theengineeraccelerator/Arduino-Electronic-Load/1 Product Definition/Archive/ArduinoElectronicLoad_Feature_Diagram_new.pdf

# Key

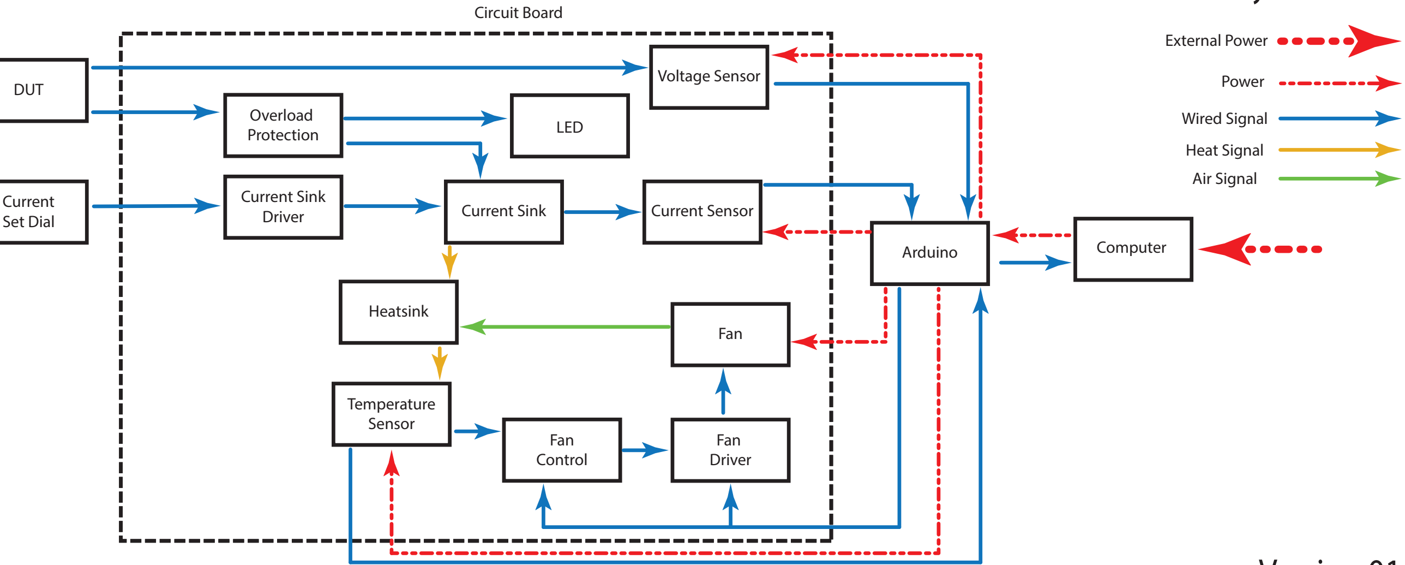
[picture p1: figure]
Power; Wired Signal; External Power; Voltage Sensor; Arduino; Current Sensor; Circuit Board; Current Sink Driver; Current; Set Dial; Current Sink; Computer; Overload Protection; Temperature Sensor; Fan Control; LED; DUT; Heatsink; Fan Driver; Heat Signal; Fan; Air Signal

# Version 01

# Arduino Electronic Load Feature Block Diagram
