theengineeraccelerator/Arduino-Electronic-Load/3 Realization/Working_Import_BOM_Ver05.xlsx

Sheet: BOM
Author
Date
Project
Version
Part | Value | Manufacturing | Manufacturing_num | Package | Vendor | Vendor_Part_num
3.5MM_JACK_IN | 35RASMT4BHNTRX | Switchcraft | 35RASMT4BHNTRX | 5 Pad Audio Jack | Mouser | 502-35RASMT4BHNTRX
3.5MM_JACK_OUT | 35RASMT4BHNTRX | Switchcraft | 36RASMT4BHNTRX | 6 Pad Audio Jack | Mouser | 503-35RASMT4BHNTRX
10KPOT | PRS11S-N20F-103B1
BATTERY
C1 | .05uF
C2 | 250uF
C5 | 10uF
OP_AMP
R1 | 10
R2 | 1.2K

Sheet: BOM Check
Part | Value | MANUFACTURING | MANUFACTURING_NUM | PACKAGE | VENDOR | VENDOR_PART_NUM
3.5MM_JACK_IN | 35RASMT4BHNTRX | Switchcraft | 35RASMT4BHNTRX | 5 Pad Audio Jack | Mouser | 502-35RASMT4BHNTRX
3.5MM_JACK_OUT | 35RASMT4BHNTRX | Switchcraft | 36RASMT4BHNTRX | 6 Pad Audio Jack | Mouser | 503-35RASMT4BHNTRX
10KPOT | PRS11S-N20F-103B1
BATTERY
C1 | .05uF
C2 | 250uF
C5 | 10uF
OP_AMP
R1 | 10
R2 | 1.2K

Sheet: Back Annotation Script
Manufacturer | MFG_Part_Number | Package | Vendor | Vendor_Part_num
Attribute 3.5MM_JACK_IN Manufacturing 'Switchcraft'; | Attribute 3.5MM_JACK_IN Manufacturing_num '35RASMT4BHNTRX'; | Attribute 3.5MM_JACK_IN Package '5 Pad Audio Jack'; | Attribute 3.5MM_JACK_IN Vendor 'Mouser'; | Attribute 3.5MM_JACK_IN Vendor_Part_num '502-35RASMT4BHNTRX';
Attribute 3.5MM_JACK_OUT Switchcraft 'Switchcraft'; | Attribute 3.5MM_JACK_OUT 35RASMT4BHNTRX '36RASMT4BHNTRX'; | Attribute 3.5MM_JACK_OUT 5 Pad Audio Jack '6 Pad Audio Jack'; | Attribute 3.5MM_JACK_OUT Mouser 'Mouser'; | Attribute 3.5MM_JACK_OUT 502-35RASMT4BHNTRX '503-35RASMT4BHNTRX';
Attribute 10KPOT Switchcraft ''; | Attribute 10KPOT 36RASMT4BHNTRX ''; | Attribute 10KPOT 6 Pad Audio Jack ''; | Attribute 10KPOT Mouser ''; | Attribute 10KPOT 503-35RASMT4BHNTRX '';
Attribute BATTERY ''; | Attribute BATTERY ''; | Attribute BATTERY ''; | Attribute BATTERY ''; | Attribute BATTERY '';
Attribute C1 ''; | Attribute C1 ''; | Attribute C1 ''; | Attribute C1 ''; | Attribute C1 '';
Attribute C2 ''; | Attribute C2 ''; | Attribute C2 ''; | Attribute C2 ''; | Attribute C2 '';
Attribute C5 ''; | Attribute C5 ''; | Attribute C5 ''; | Attribute C5 ''; | Attribute C5 '';
Attribute OP_AMP ''; | Attribute OP_AMP ''; | Attribute OP_AMP ''; | Attribute OP_AMP ''; | Attribute OP_AMP '';
Attribute R1 ''; | Attribute R1 ''; | Attribute R1 ''; | Attribute R1 ''; | Attribute R1 '';
Attribute R2 ''; | Attribute R2 ''; | Attribute R2 ''; | Attribute R2 ''; | Attribute R2 '';
Attribute ''; | Attribute ''; | Attribute ''; | Attribute ''; | Attribute '';
Attribute ''; | Attribute ''; | Attribute ''; | Attribute ''; | Attribute '';
Attribute ''; | Attribute ''; | Attribute ''; | Attribute ''; | Attribute '';
Attribute ''; | Attribute ''; | Attribute ''; | Attribute ''; | Attribute '';
Attribute ''; | Attribute ''; | Attribute ''; | Attribute ''; | Attribute '';
Attribute ''; | Attribute ''; | Attribute ''; | Attribute ''; | Attribute '';
Attribute ''; | Attribute ''; | Attribute ''; | Attribute ''; | Attribute '';
Attribute ''; | Attribute ''; | Attribute ''; | Attribute ''; | Attribute '';
Attribute ''; | Attribute ''; | Attribute ''; | Attribute ''; | Attribute '';
Attribute ''; | Attribute ''; | Attribute ''; | Attribute ''; | Attribute '';
Attribute ''; | Attribute ''; | Attribute ''; | Attribute ''; | Attribute '';
Attribute ''; | Attribute ''; | Attribute ''; | Attribute ''; | Attribute '';
Attribute ''; | Attribute ''; | Attribute ''; | Attribute ''; | Attribute '';
Attribute ''; | Attribute ''; | Attribute ''; | Attribute ''; | Attribute '';
Attribute ''; | Attribute ''; | Attribute ''; | Attribute ''; | Attribute '';
Attribute ''; | Attribute ''; | Attribute ''; | Attribute ''; | Attribute '';
Attribute ''; | Attribute ''; | Attribute ''; | Attribute ''; | Attribute '';
Attribute ''; | Attribute ''; | Attribute ''; | Attribute ''; | Attribute '';
