theengineeraccelerator/Arduino-Electronic-Load/1 Product Definition/ArduinoElectronicLoad_Feature_Diagram_ver3- MK Comments.pdf

# Key

# Arduino Electronic Load Feature Block Diagram

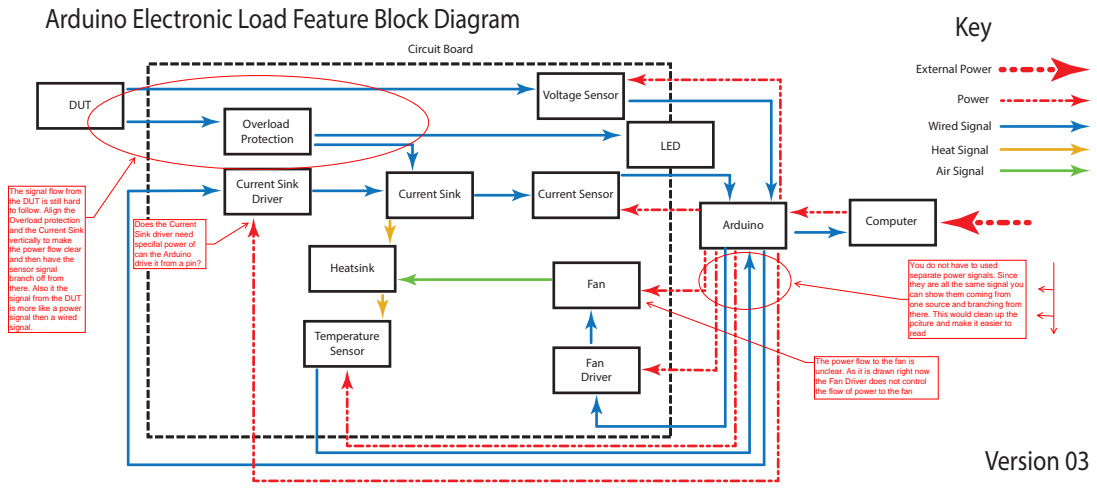
[picture p2: page 1]
Power; Wired Signal; External Power; Version 03; Voltage Sensor; Arduino; Current Sensor; Circuit Board; Current Sink Driver; Current Sink; Computer; Overload Protection; Temperature Sensor; LED; DUT; Heatsink; Fan Driver; Heat Signal; Fan; Air Signal
