theengineeraccelerator/Arduino-Electronic-Load/2 Architecture/Arduino Electronic Load Hardware Block Diagram Ver2 - MK Comments.pdf

# Arduino Electronic Load Hardware Block Diagram V02

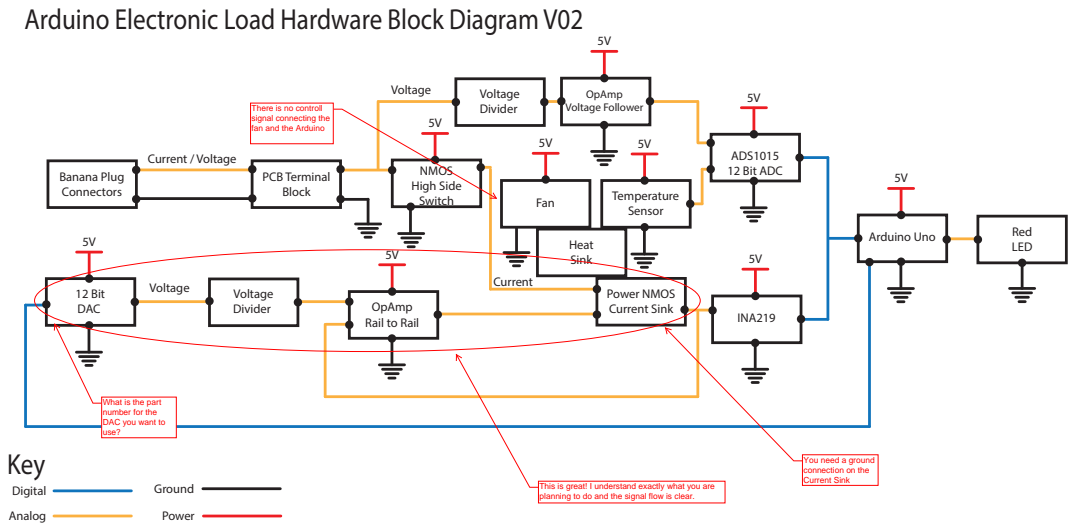
[picture p3: page 1]
Arduino Uno; Red; LED; Power NMOS Current Sink; PCB Terminal Block; Key; Digital; Power; Ground; Analog; ADS1015 12 Bit ADC; INA219; NMOS High Side Switch; Banana Plug Connectors; Fan; Current / Voltage; 12 Bit DAC; Heat Sink; Temperature Sensor; Current; Voltage; Voltage Divider; OpAmp Voltage Follower

OpAmp
Rail to Rail

# Arduino Electronic Load Hardware Block Diagram V02
