theengineeraccelerator/Arduino-Electronic-Load/3 Realization/Arduino Electronic Load BRD - MK Comments.pdf

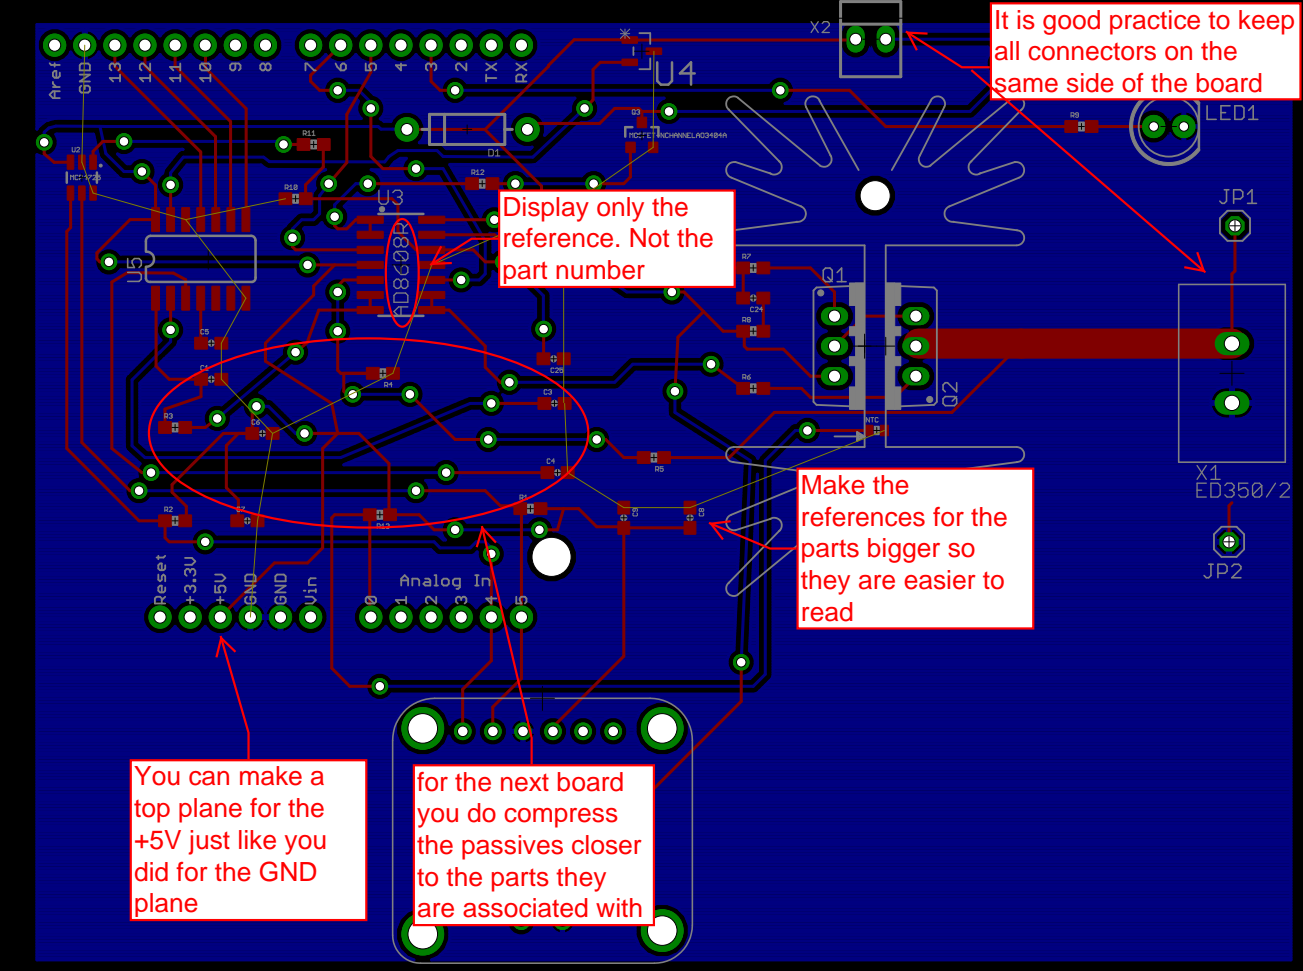
[picture p4: page 1]
