theengineeraccelerator/Arduino-Electronic-Load/3 Realization/Arduino Electronic Load BRD.pdf

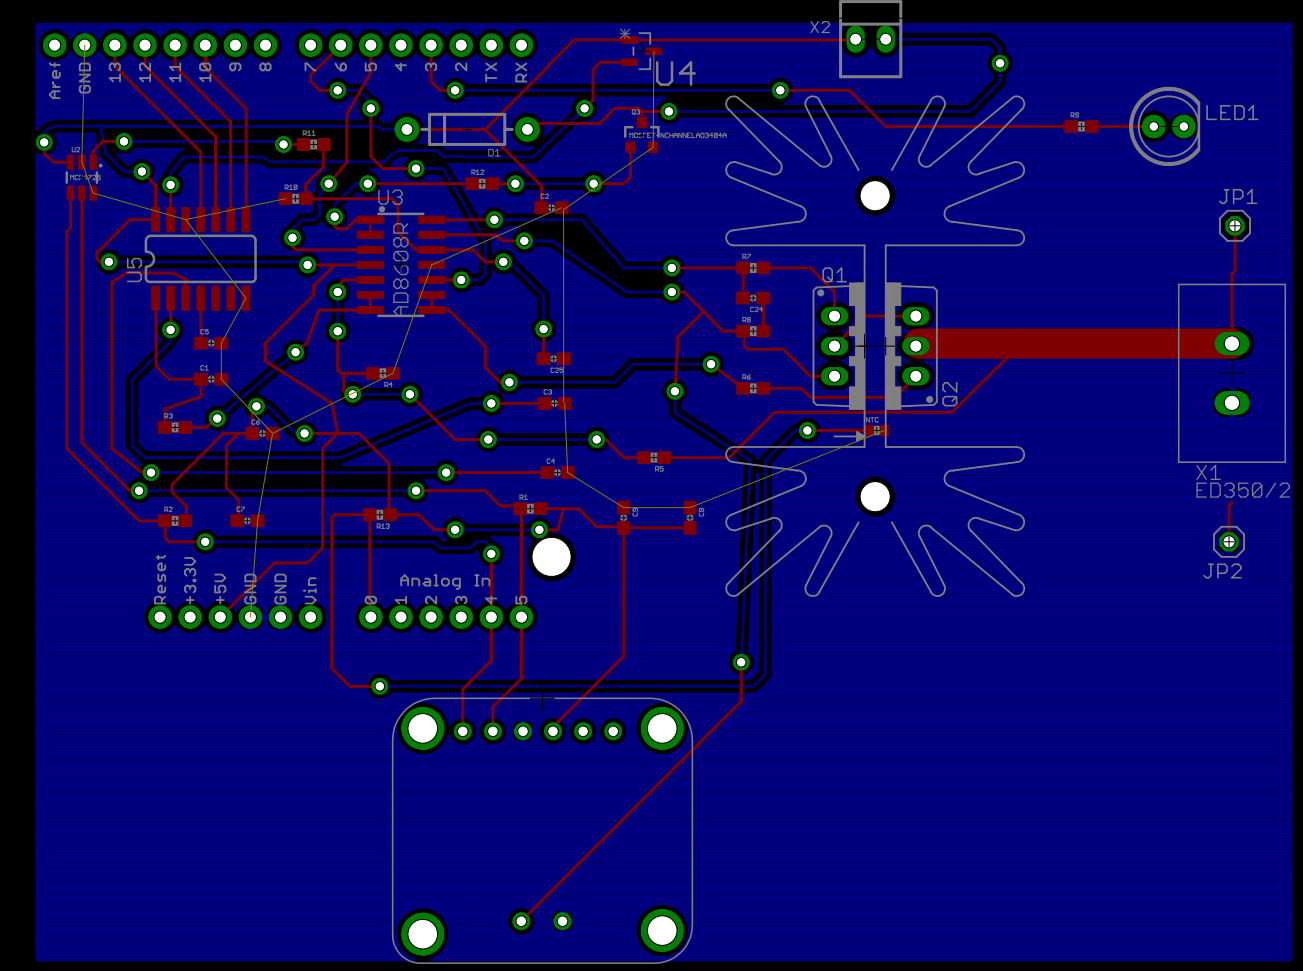
[picture p5: page 1]
