theengineeraccelerator/Arduino-Electronic-Load/3 Realization/Arduino Electronic Load SCH - MK Comments.pdf

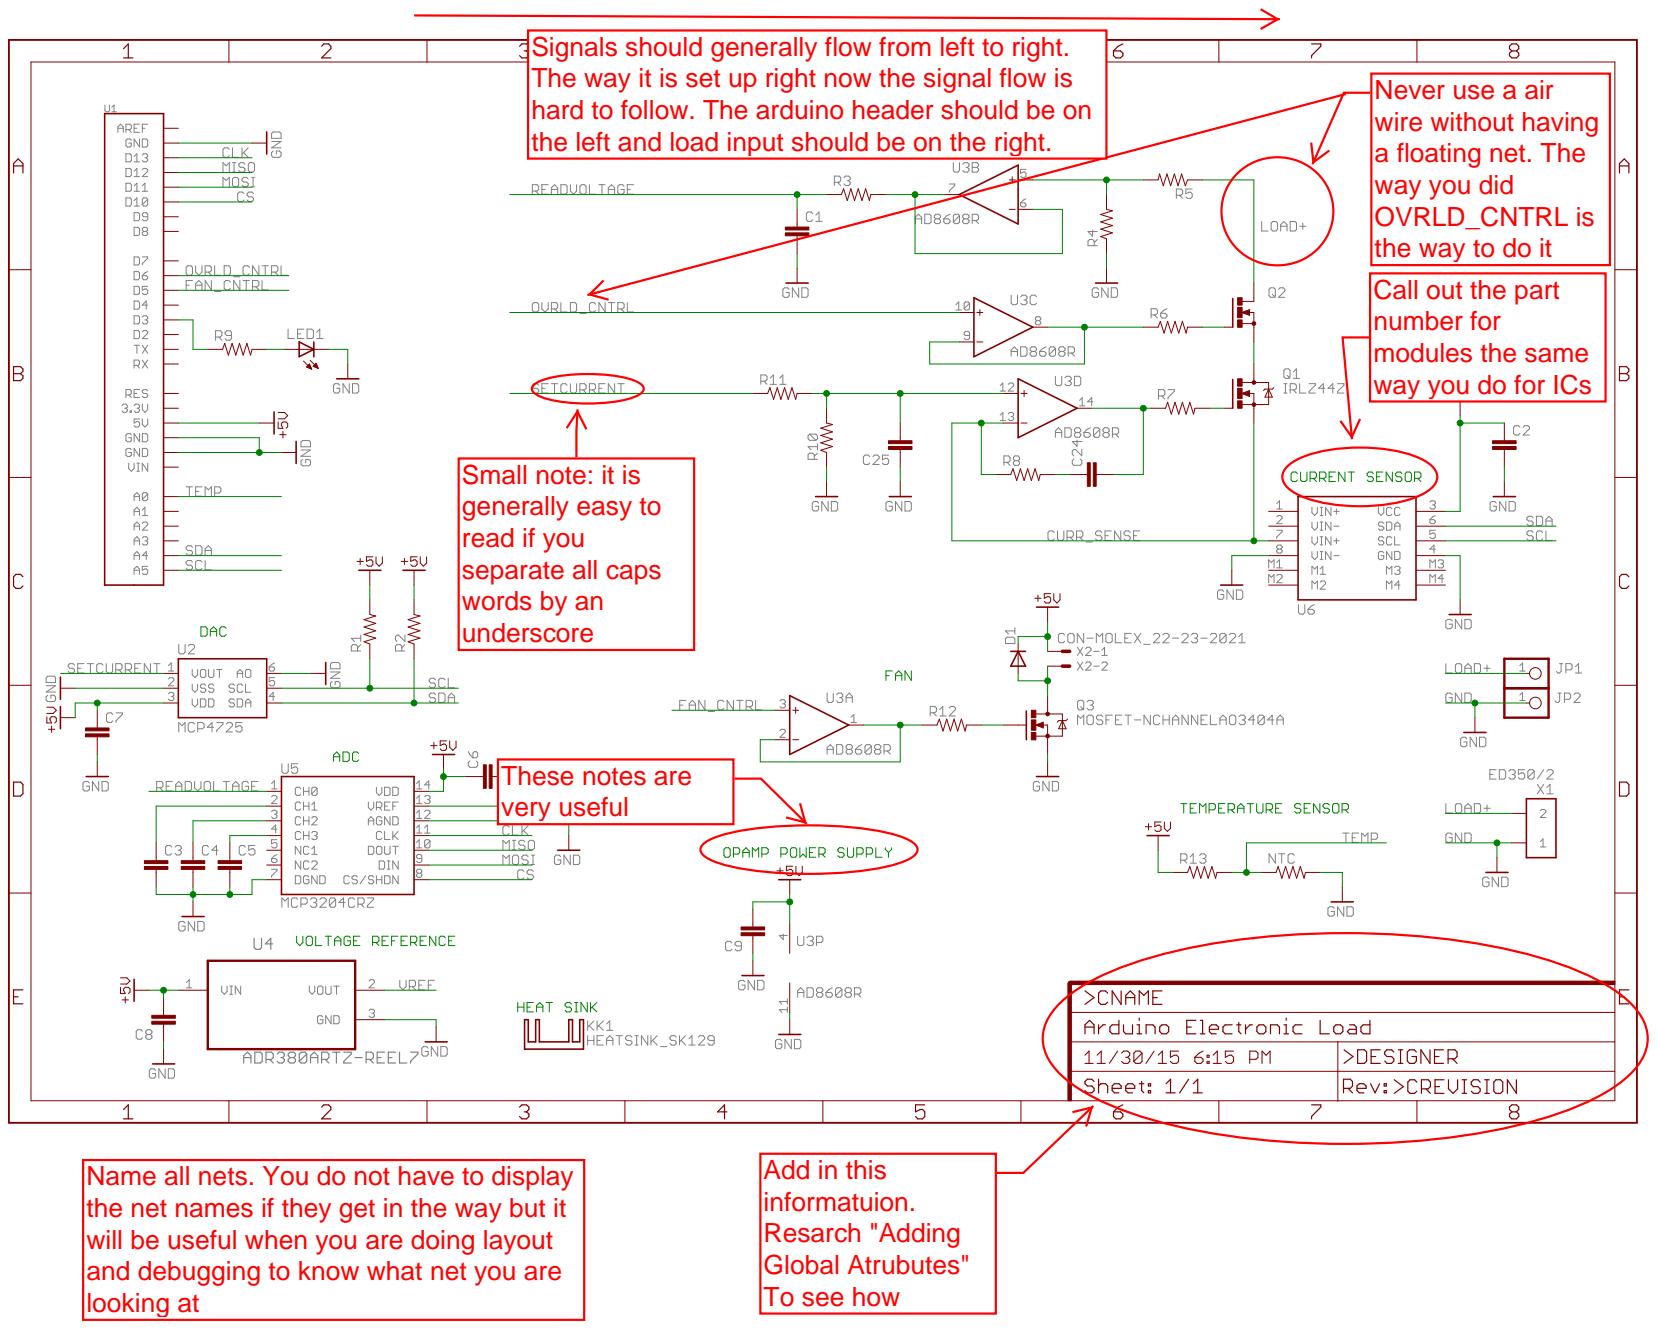
[picture p6: page 1]
