theengineeraccelerator/Arduino-Electronic-Load/3 Realization/Arduino Electronic Load SCH.pdf

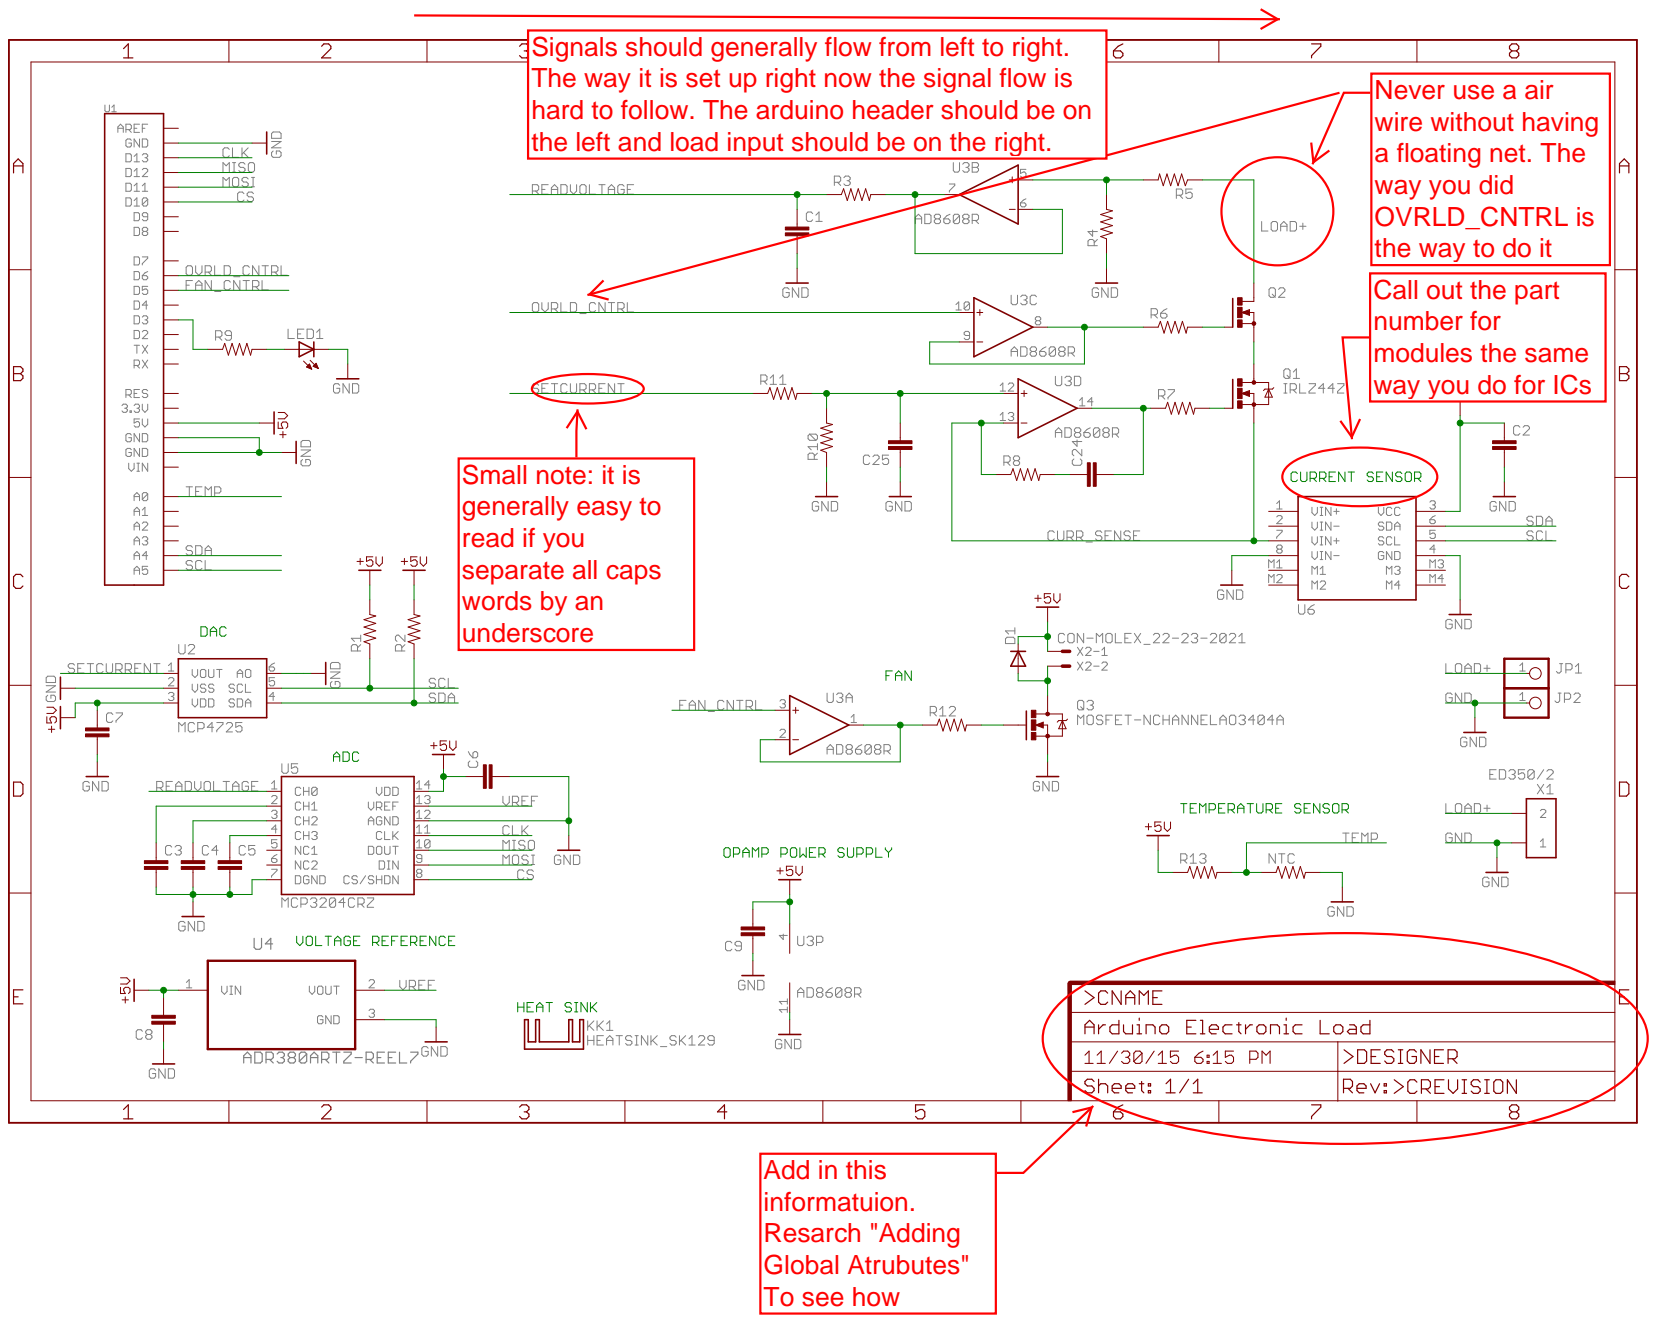
[picture p7: page 1]
