theengineeraccelerator/Arduino-Electronic-Load/3 Realization/Arduino Electronic Load_Ver06.brd

## EAGLE design 3 Realization/Arduino Electronic Load_Ver06.brd (2017-09-23)

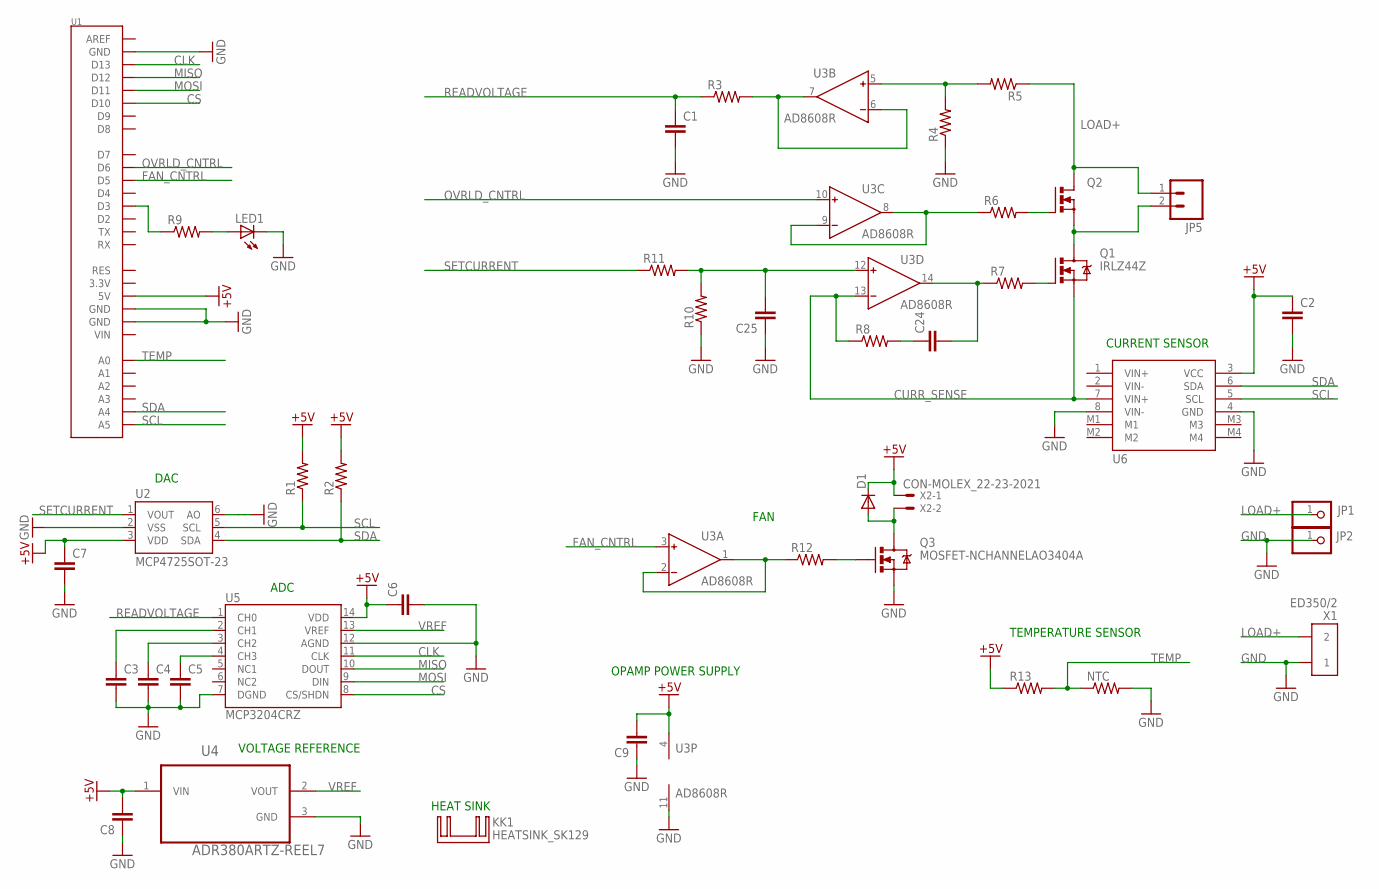
[picture p8: schematic Arduino Electronic Load_Ver06.sch]

Parts:
C1, C2, C3, C4, C5, C6, C7, C8, C9, C24, C25: CAP0603-CAP; 0603-CAP
D1: DIODEPTH; DIODE-1N4001
JP1, JP2: PINHEAD_PINHD-1X1; PINHEAD_1X01
JP5: M02; 1X02_LONGPADS
KK1: HEATSINK_SK129; HEATSINK_SK129-HOLE
LED1: LED5MM
NTC: RESISTOR0402-RES; 0402-RES
Q1: IRLZ44Z; TO220BV_1
Q2: PMOSFET_NTO220BV; TO220BV
Q3: MOSFET-NCHANNELAO3404A; SOT23-3
R1, R2, R3, R4, R5, R6, R7, R8, R9, R10, R11, R12, R13: RESISTOR0603-RES; 0603-RES
U1: ARDUINO_SHIELD; DUEMILANOVE_SHIELD
U2: MCP4725SOT-23; SOT23-6
U3: AD8608R; SO14
U4: ADR380ARTZ-REEL7; SOT95P237X112-3N
U5: MCP3204CRZ; SOIC-14
U6: INA219
X1: ED350/2
X2: CON-MOLEX_22-23-2021

Connections:
+5V: C2.1, C6.1, C7.1, C8.2, C9.2, D1.C, R1.2, R2.2, R13.1, U1.5V, U2.3 (VDD), U3.4 (V+), U4.1 (VIN), U5.14 (VDD), U6.3 (VCC), X2.1
CLK: U1.D13, U5.11 (CLK)
CS: U1.D10, U5.8 (CS/SHDN)
CURR_SENSE: Q1.S, R8.1, U3.13 (IN-), U6.7 (VIN+)
FAN_CNTRL: U1.D5, U3.3 (IN+)
GND: C1.2, C2.2, C3.2, C4.2, C5.2, C6.2, C7.2, C8.1, C9.1, C25.1, JP2.1, LED1.K (C), NTC.2, Q3.2 (S), R4.1, R10.1, U1.GND@0 (GND), U1.GND@1 (GND), U1.GND@2 (GND), U2.2 (VSS), U2.6 (AO), U3.11 (V-), U4.3 (GND), U5.7 (DGND), U5.12 (AGND), U6.4 (GND), U6.8 (VIN-), X1.P$1 (1)
LOAD+: JP1.1, JP5.1, Q2.D, R5.1, X1.P$2 (2)
MISO: U1.D12, U5.10 (DOUT)
MOSI: U1.D11, U5.9 (DIN)
unnamed: R9.1, U1.D3
unnamed: LED1.A, R9.2
unnamed: R12.1, U3.1 (OUT), U3.2 (IN-)
unnamed: Q3.1 (G), R12.2
unnamed: C3.1, U5.2 (CH1)
unnamed: R3.2, U3.6 (IN-), U3.7 (OUT)
unnamed: R6.1, U3.8 (OUT), U3.9 (IN-)
unnamed: R4.2, R5.2, U3.5 (IN+)
unnamed: Q2.G, R6.2
unnamed: JP5.2, Q1.D, Q2.S
unnamed: Q1.G, R7.2
unnamed: C24.2, R7.1, U3.14 (OUT)
unnamed: C4.1, U5.3 (CH2)
unnamed: C24.1, R8.2
unnamed: C5.1, U5.4 (CH3)
unnamed: C25.2, R10.2, R11.2, U3.12 (IN+)
unnamed: D1.A, Q3.3 (D), X2.2
OVRLD_CNTRL: U1.D6, U3.10 (IN+)
READVOLTAGE: C1.1, R3.1, U5.1 (CH0)
SCL: R1.1, U1.A5, U2.5 (SCL), U6.5 (SCL)
SDA: R2.1, U1.A4, U2.4 (SDA), U6.6 (SDA)
SETCURRENT: R11.1, U2.1 (VOUT)
TEMP: NTC.1, R13.2, U1.A0
VREF: U4.2 (VOUT), U5.13 (VREF)

Notes on the sheet:
DAC
ADC
VOLTAGE REFERENCE
CURRENT SENSOR
HEAT SINK
OPAMP POWER SUPPLY
FAN
TEMPERATURE SENSOR

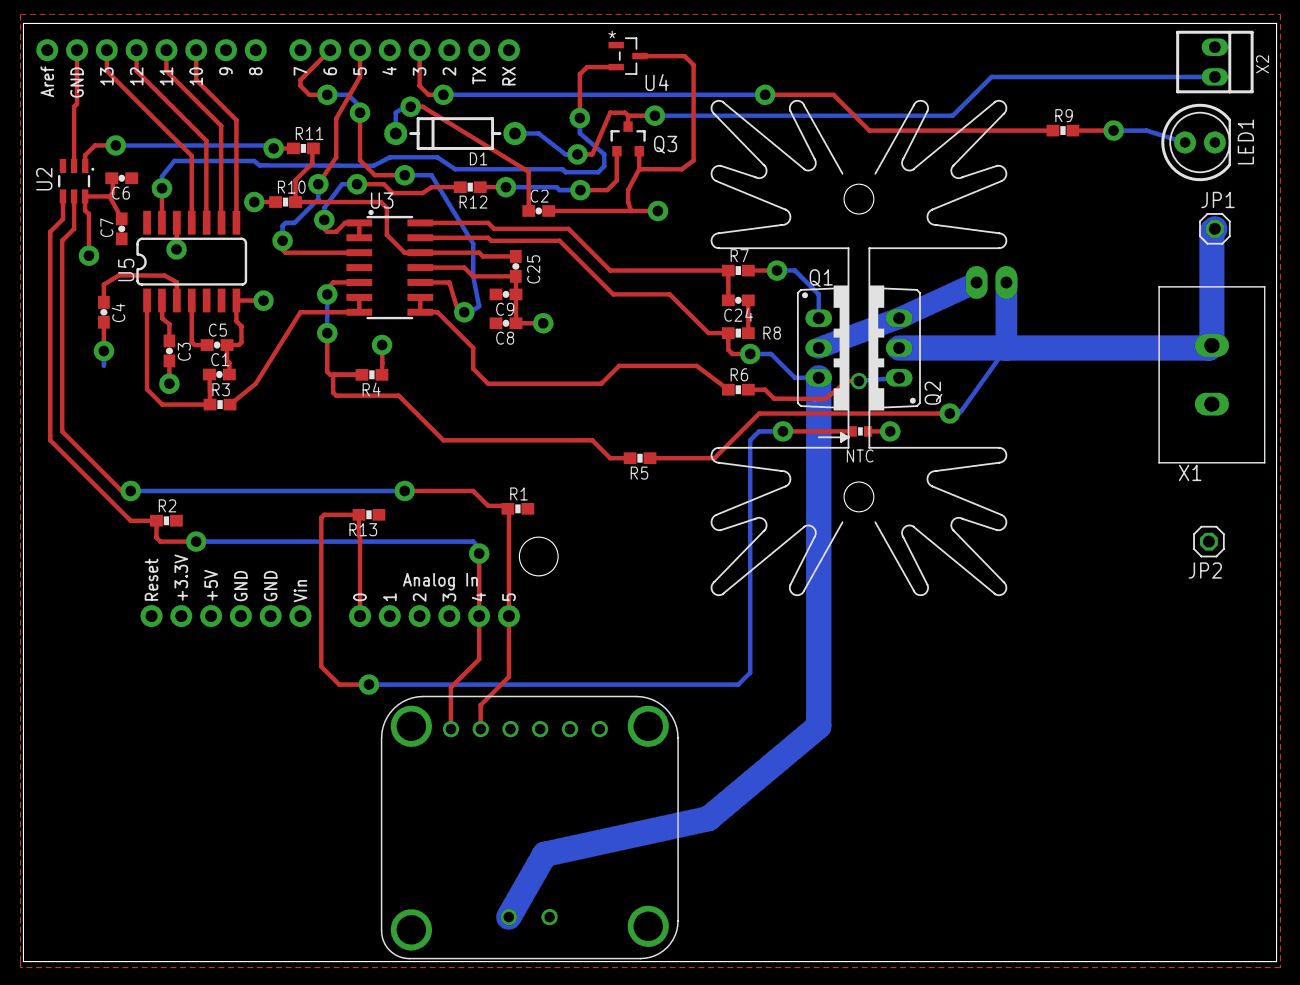
[picture p9: board Arduino Electronic Load_Ver06.brd from above]

Board: 2 copper layers, 106.9 x 80.0 mm, 42 parts (0 on the bottom side), 33 nets.
