theengineeraccelerator/Arduino-Electronic-Load/(commit log)

2017-09-23 Inital Upload
    [Arduino Electronic Load.brd, Arduino Electronic Load.sch, Arduino Electronic Load_Ver03.brd, Arduino Electronic Load_Ver03.sch, Arduino Electronic Load_Ver04.brd, Arduino Electronic Load_Ver04.sch, Arduino Electronic Load_Ver05.brd, Arduino Electronic Load_Ver05.sch]
2017-09-27 Flow Diagram
